hoanggtrn/Fingerprint-time-attendance-machine/PCB/layer.png

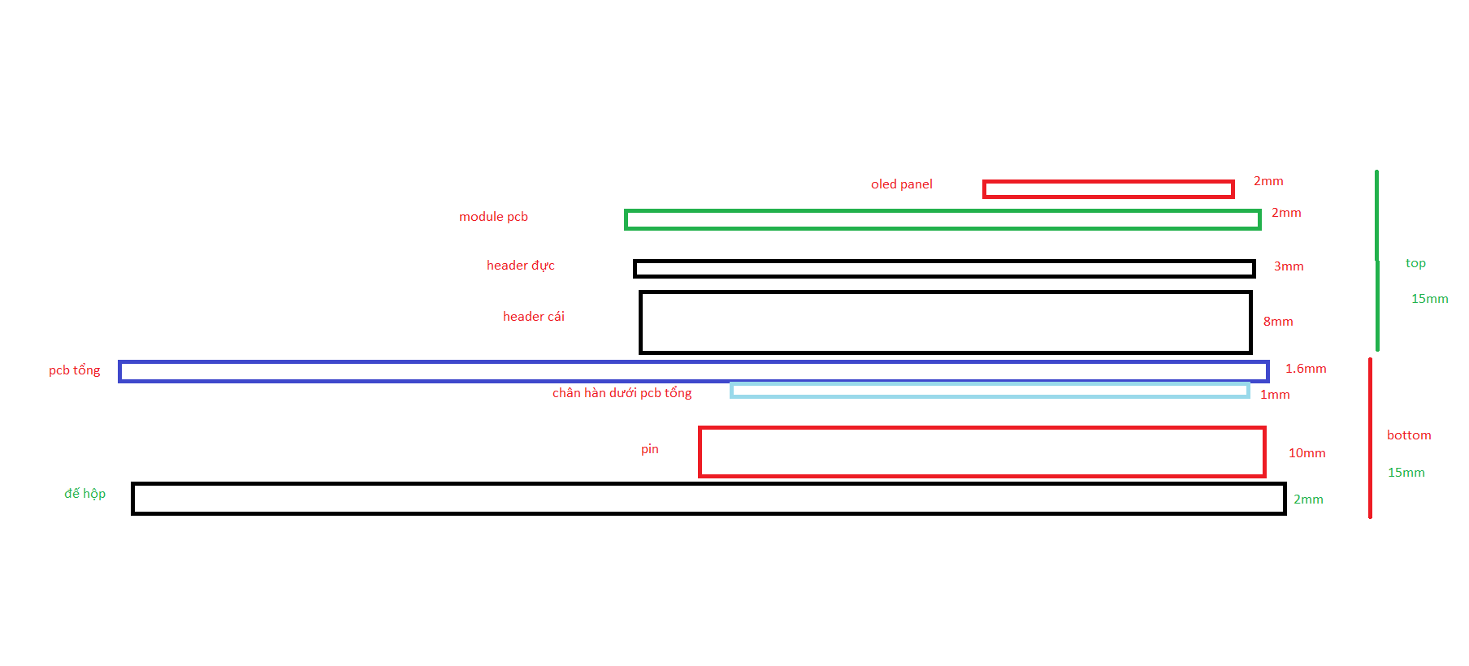
PCB/layer.png
