hoanggtrn/Fingerprint-time-attendance-machine/PCB/PCB_PCB_Do an 1_3_2023-06-01.png

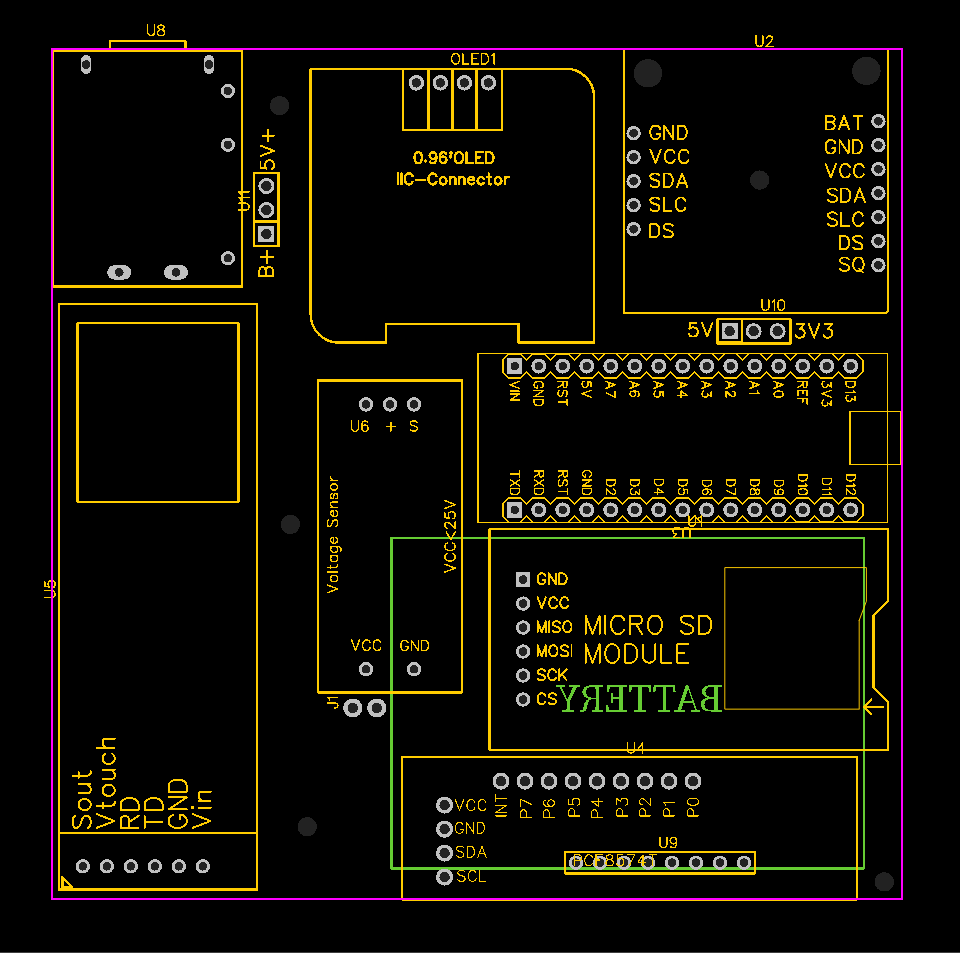
PCB/PCB_PCB_Do an 1_3_2023-06-01.png
