hoanggtrn/Fingerprint-time-attendance-machine/Schematic/arduino nano.png

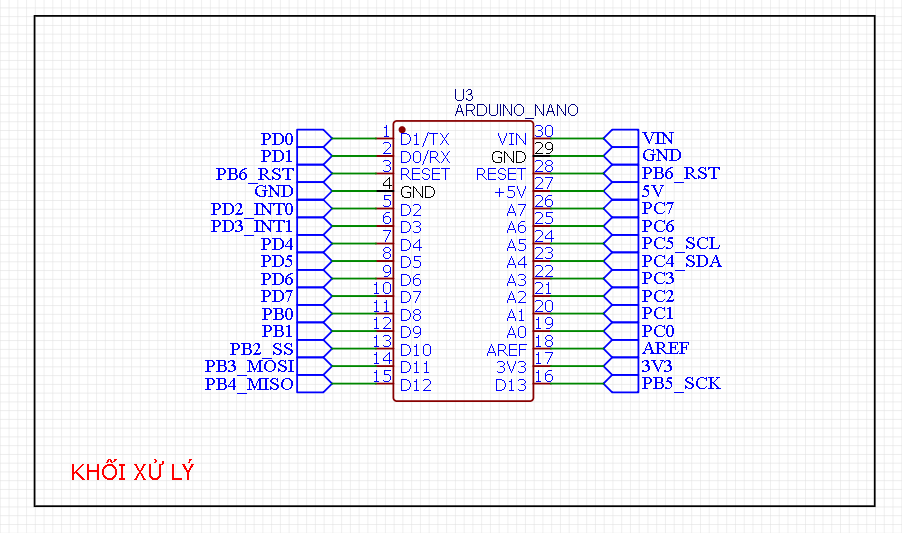
Schematic/arduino nano.png
