hoanggtrn/Fingerprint-time-attendance-machine/Schematic/Schematic_Do an 1_FINAL.png

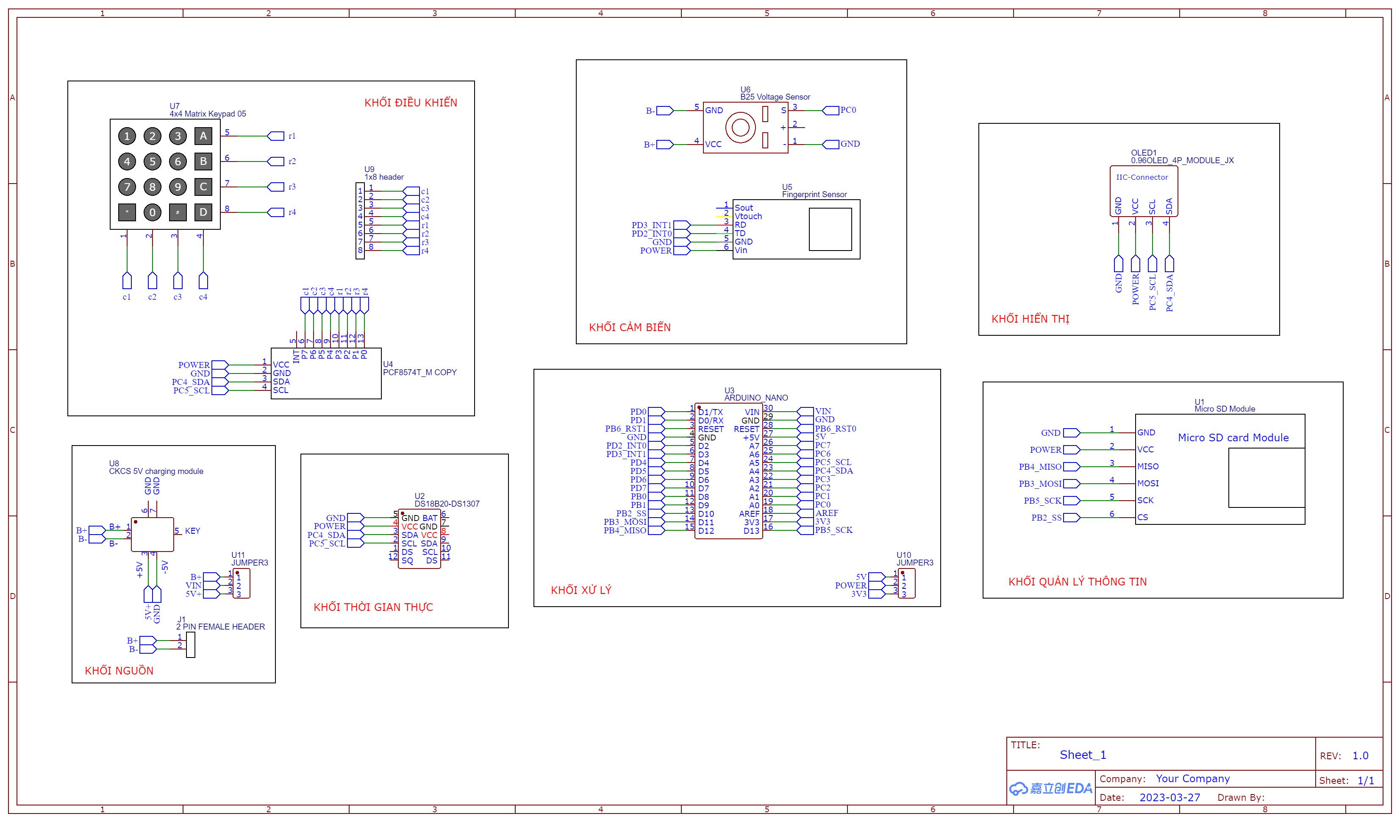
Schematic/Schematic_Do an 1_FINAL.png
