hoanggtrn/Fingerprint-time-attendance-machine/Box 3D printed/BOX_TOP_v0.0.4.step

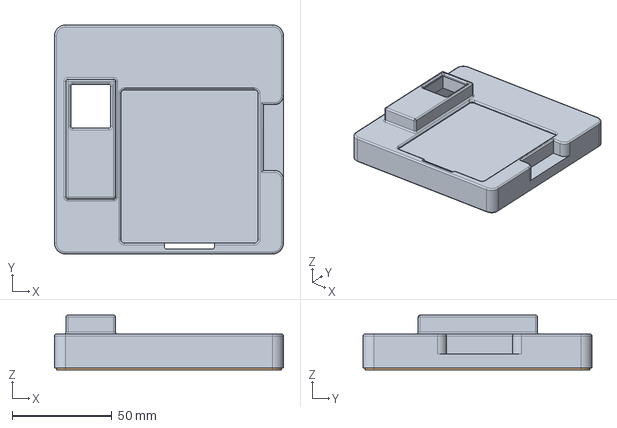
[picture p38: CAD file, 2025-09-16]
Box 3D printed/BOX_TOP_v0.0.4.step
115.0 x 115.0 x 27.5 mm
Drawing
Top
