hoanggtrn/Fingerprint-time-attendance-machine/PCB/PCB_Do an 1_3_2023-06-01.dxf

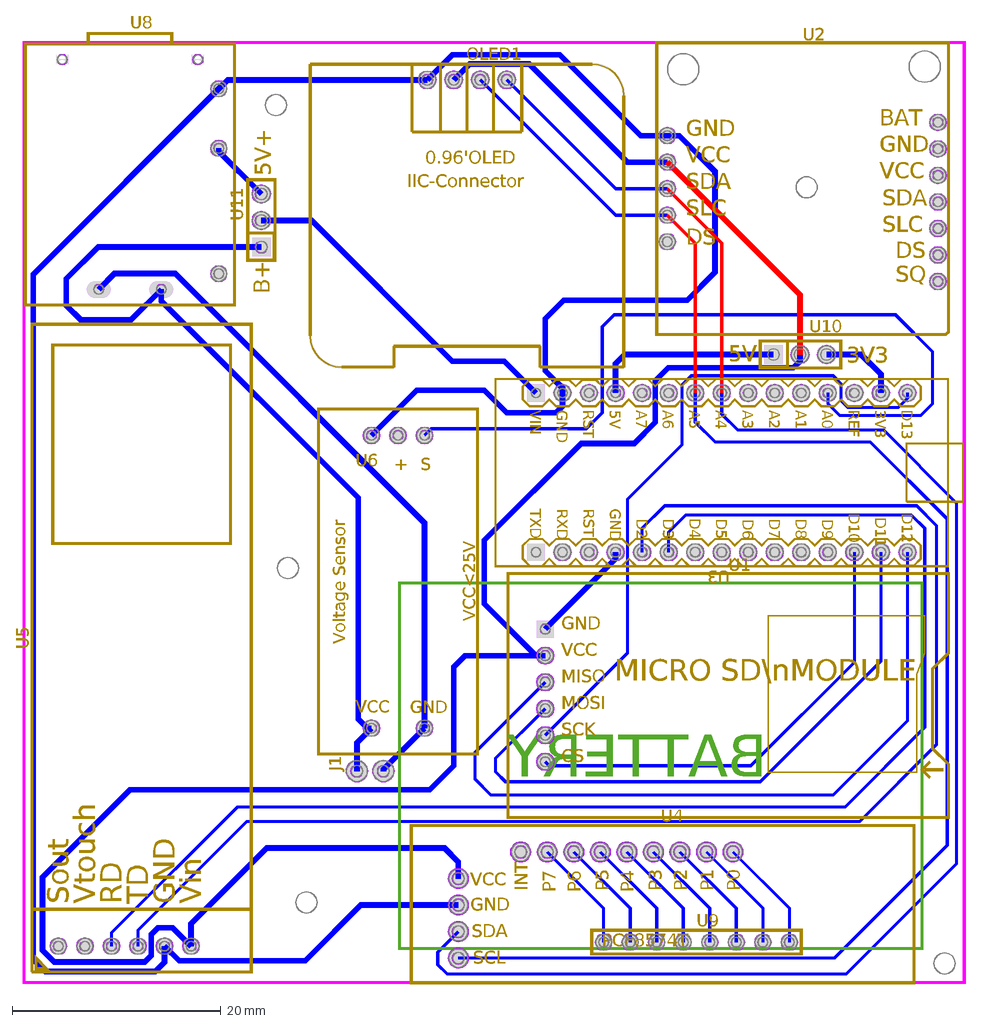
[picture p39: CAD file, 2025-09-16]
PCB/PCB_Do an 1_3_2023-06-01.dxf
BATTERY
B+
5V+
3V3
5V
U10
U2
SQ
DS
BAT
GND
VCC
SDA
SLC
U6
+
S
VCC<25V
Voltage Sensor
U5
Sout
Vtouch
RD
TD
Vin
J1
OLED1
IIC-Connector
0.96'OLED
U1
MISO
MOSI
SCK
CS
MICRO SD\nMODULE
U3
D13
REF
A0
A1
A2
A3
A4
A5
A6
A7
RST
VIN
D12
D11
D10
D9
D8
D7
D6
D5
D4
D3
D2
RXD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
