hoanggtrn/Fingerprint-time-attendance-machine/Box 3D printed/BOX_BOTTOM_v0.0.4.step

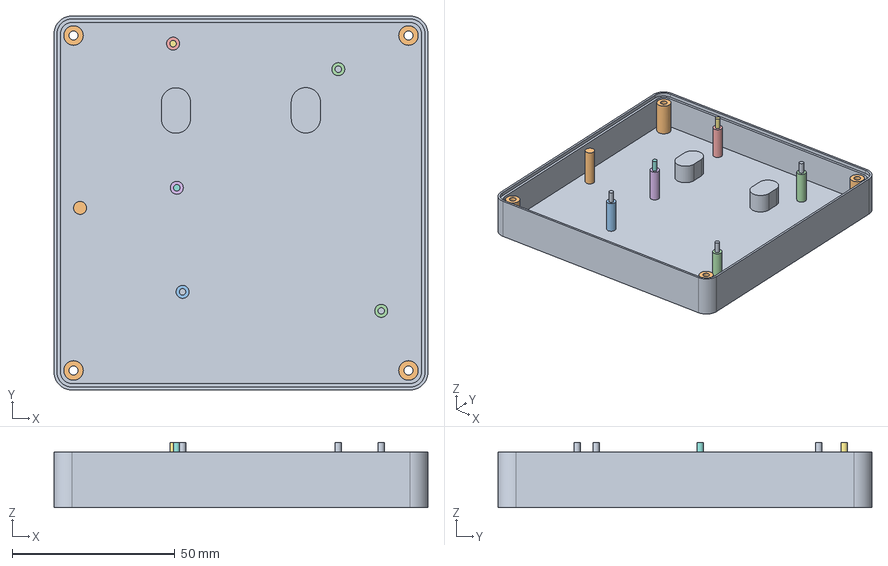
[picture p40: CAD file, 2025-09-16]
Box 3D printed/BOX_BOTTOM_v0.0.4.step
115.0 x 115.0 x 20.0 mm
Drawing
BOTTOM
