hoanggtrn/Fingerprint-time-attendance-machine/(list of files, cad)

Other CAD files:
Box 3D printed/BOX_BOTTOM_v0.0.4.stl
Box 3D printed/BOX_TOP_v0.0.4.stl
