hoanggtrn/Fingerprint-time-attendance-machine/PCB/PCB_PCB_Do an 1_3_2023-05-16.pdf

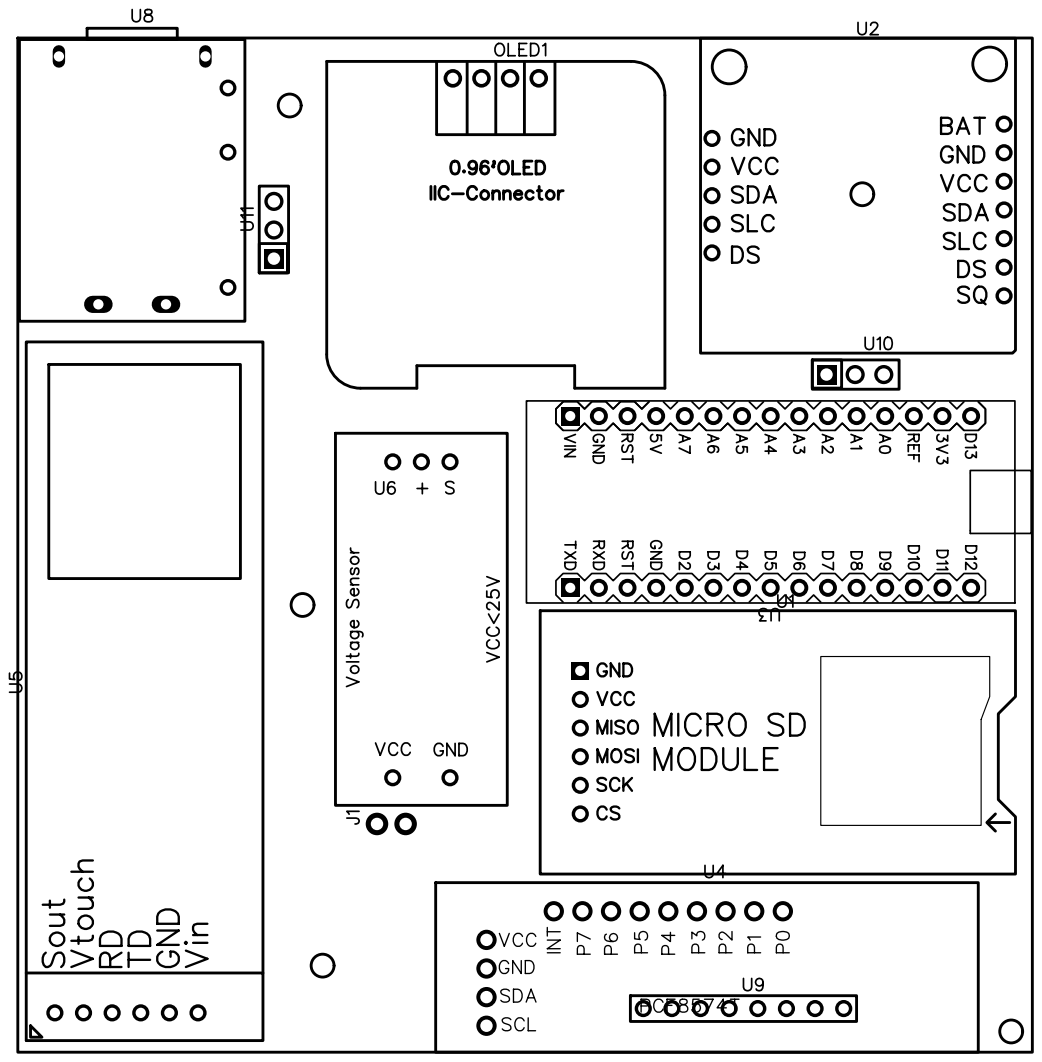
[picture p84: page 1]
