hoanggtrn/Fingerprint-time-attendance-machine/(list of files, drawings)

Other design files:
PCB/PCB_PCB_Do an 1_3_2023-06-01.json
Schematic/Schematic_Do an 1_FINAL.json
